vtheofylaktos/Astraeus-VTOL-UAV/Full-scale Astraeus/Drone CAD/render fulldrone.PNG

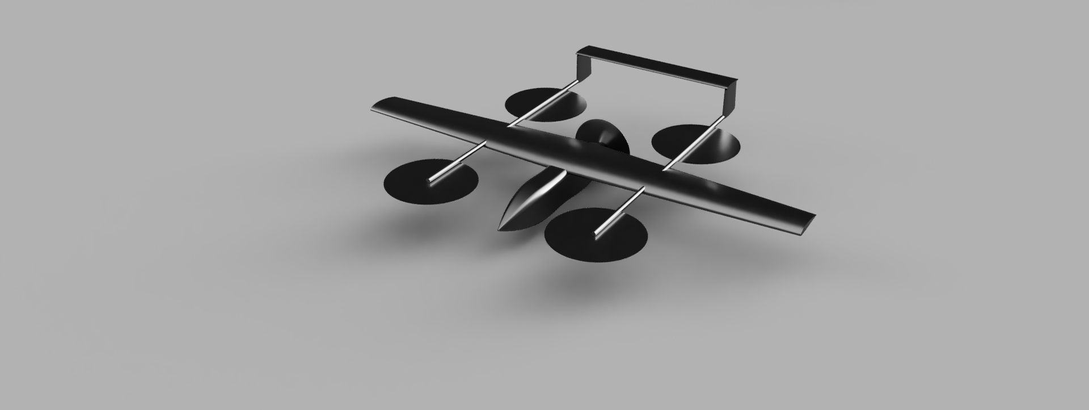
Full-scale Astraeus/Drone CAD/render fulldrone.PNG
