vtheofylaktos/Astraeus-VTOL-UAV/Full-scale Astraeus/Electrical simulations/propcalc/propCalc1/firstss.png

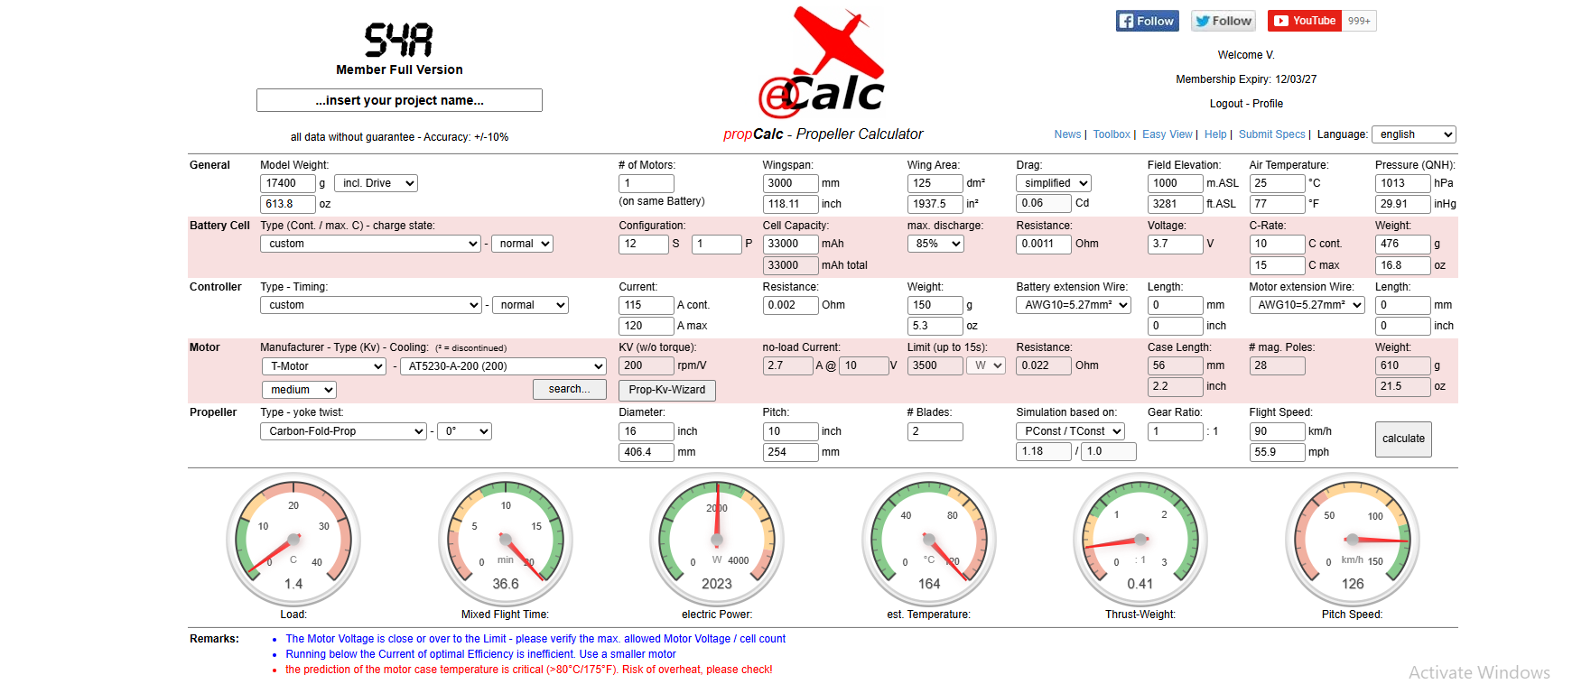
Full-scale Astraeus/Electrical simulations/propcalc/propCalc1/firstss.png
