vtheofylaktos/Astraeus-VTOL-UAV/Full-scale Astraeus/Electrical simulations/propcalc/propCalc1/fourth.png

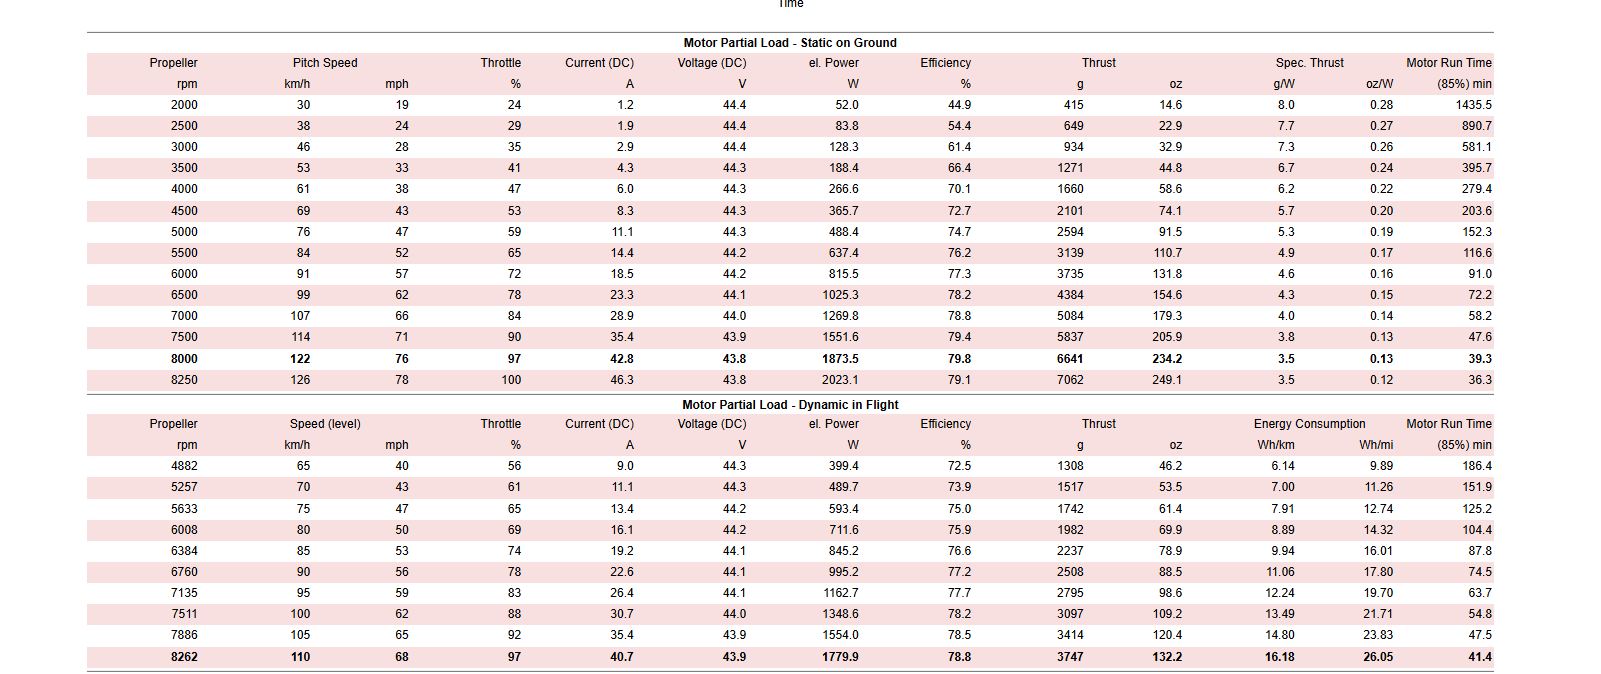
Full-scale Astraeus/Electrical simulations/propcalc/propCalc1/fourth.png
