vtheofylaktos/Astraeus-VTOL-UAV/Full-scale Astraeus/Electrical simulations/propcalc/propCalc1/second.png

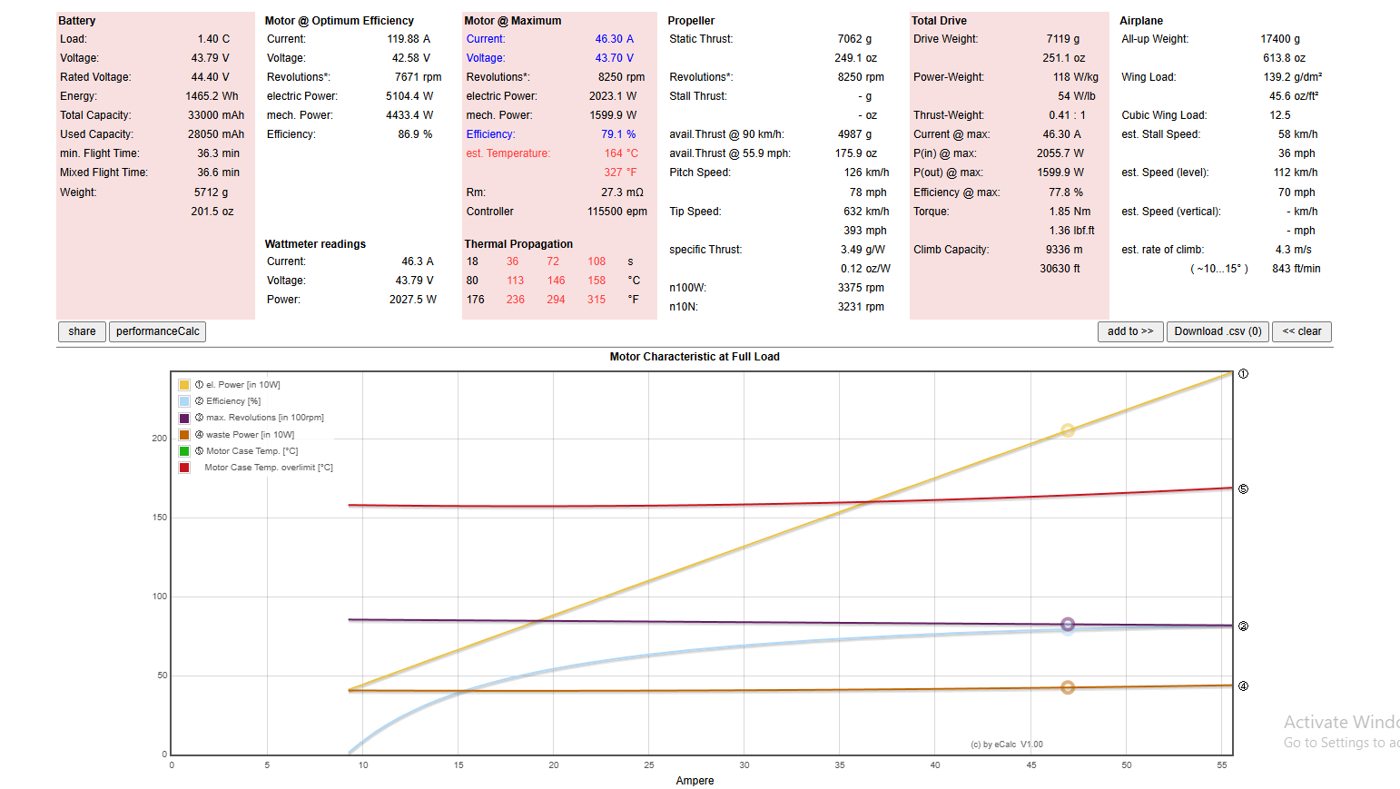
Full-scale Astraeus/Electrical simulations/propcalc/propCalc1/second.png
