vtheofylaktos/Astraeus-VTOL-UAV/Full-scale Astraeus/Electrical simulations/propcalc/propCalc1/third.png

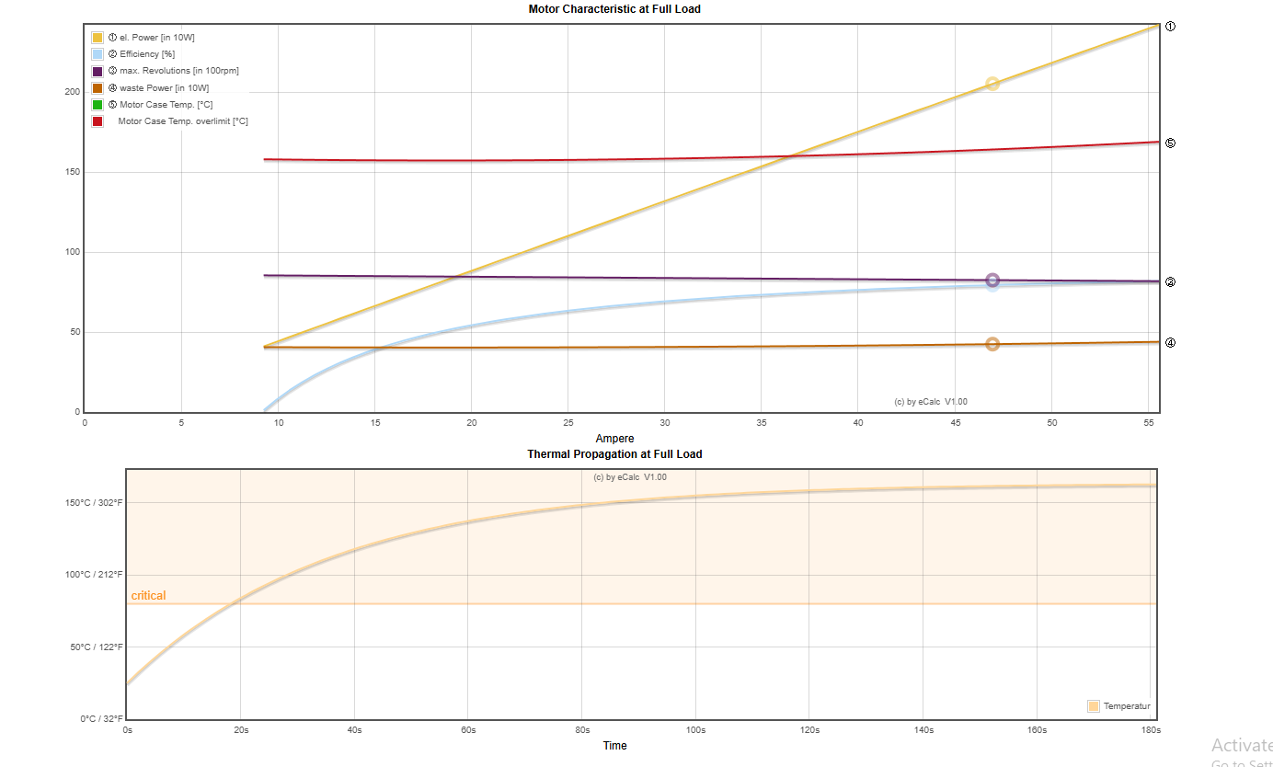
Full-scale Astraeus/Electrical simulations/propcalc/propCalc1/third.png
