vtheofylaktos/Astraeus-VTOL-UAV/Full-scale Astraeus/Electrical simulations/propcalc/propCalc2/propCalcSimulation.PNG

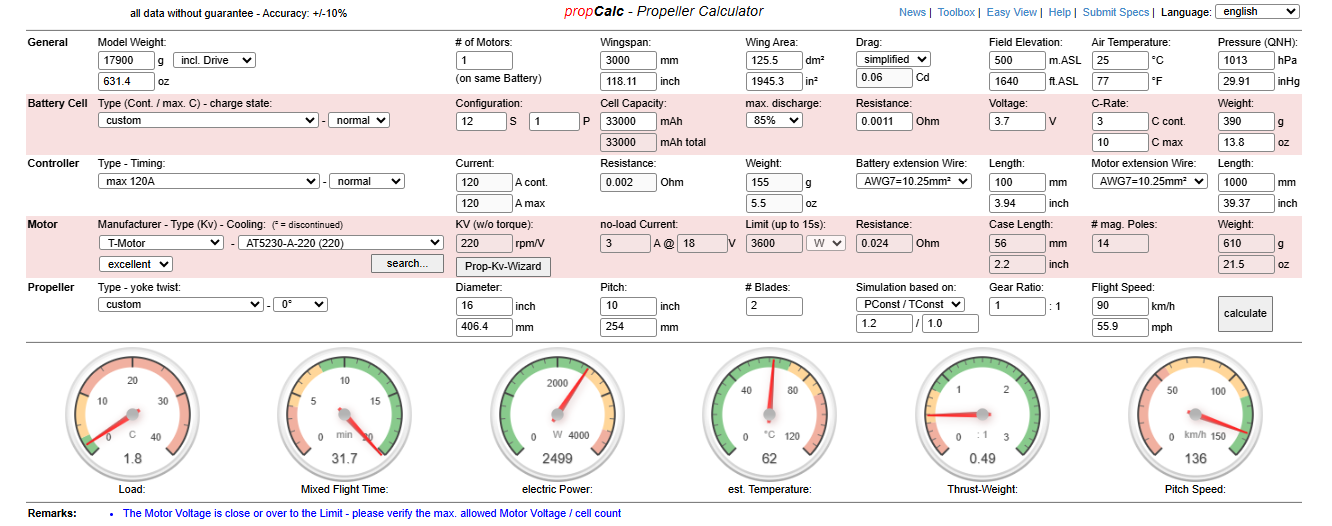
Full-scale Astraeus/Electrical simulations/propcalc/propCalc2/propCalcSimulation.PNG
