vtheofylaktos/Astraeus-VTOL-UAV/Full-scale Astraeus/Electrical simulations/xcopter/xcopter1/Screenshot 2026-03-13 004834.png

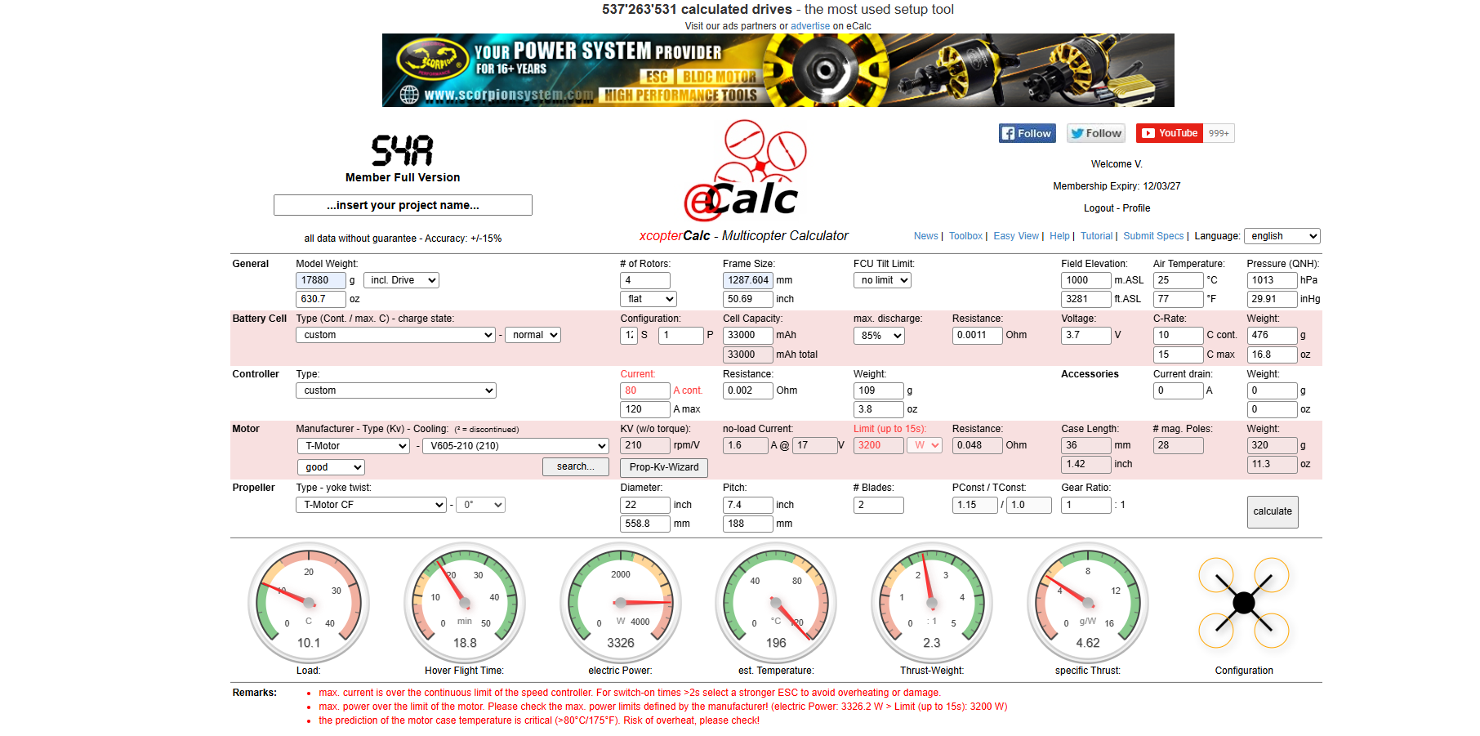
Full-scale Astraeus/Electrical simulations/xcopter/xcopter1/Screenshot 2026-03-13 004834.png
