vtheofylaktos/Astraeus-VTOL-UAV/Full-scale Astraeus/Electrical simulations/xcopter/xcopter1/Screenshot 2026-03-13 004920.png

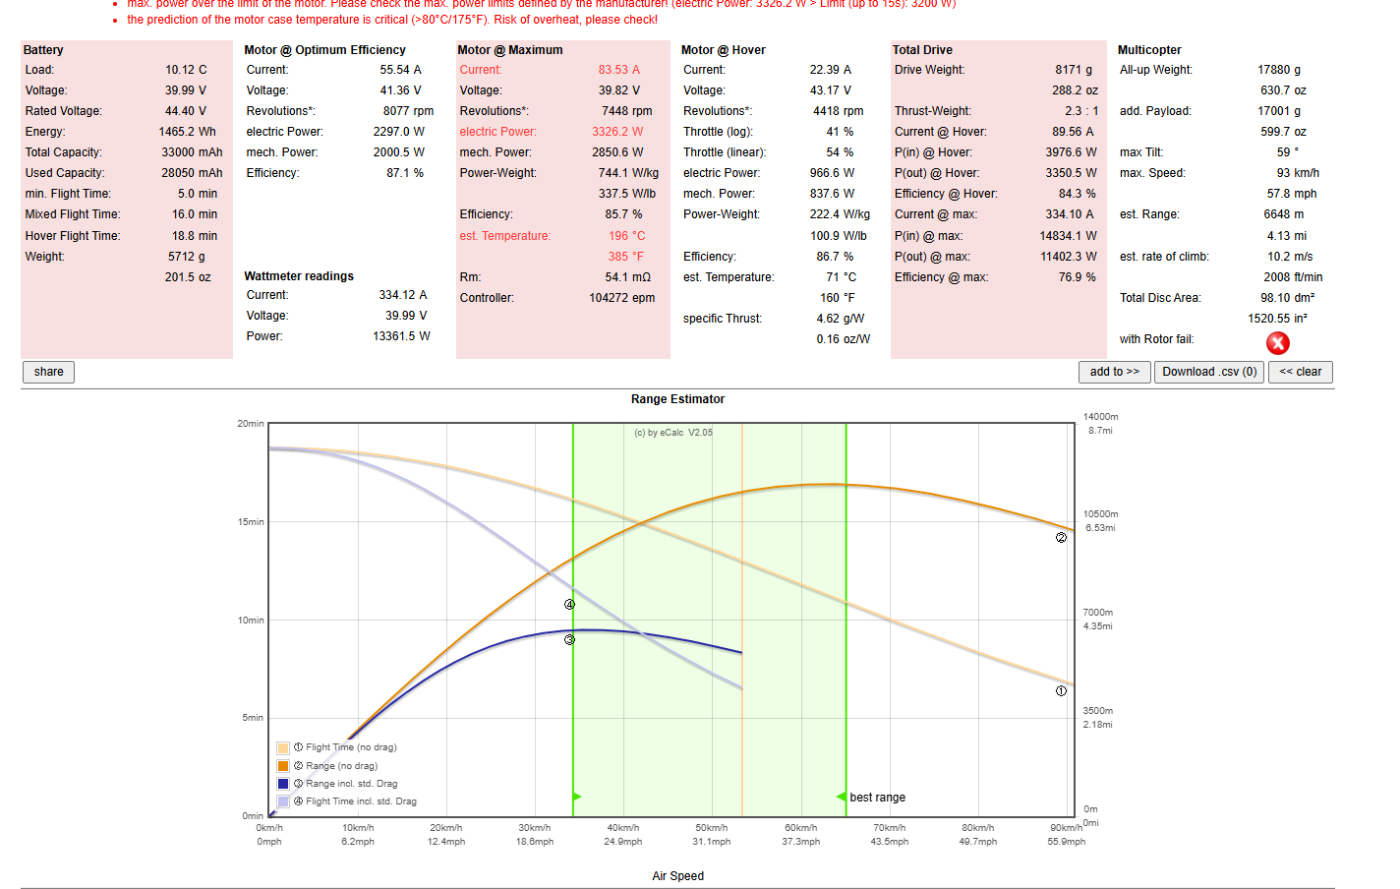
Full-scale Astraeus/Electrical simulations/xcopter/xcopter1/Screenshot 2026-03-13 004920.png
