vtheofylaktos/Astraeus-VTOL-UAV/Full-scale Astraeus/Electrical simulations/xcopter/xcopter2/NewSimulation2.PNG

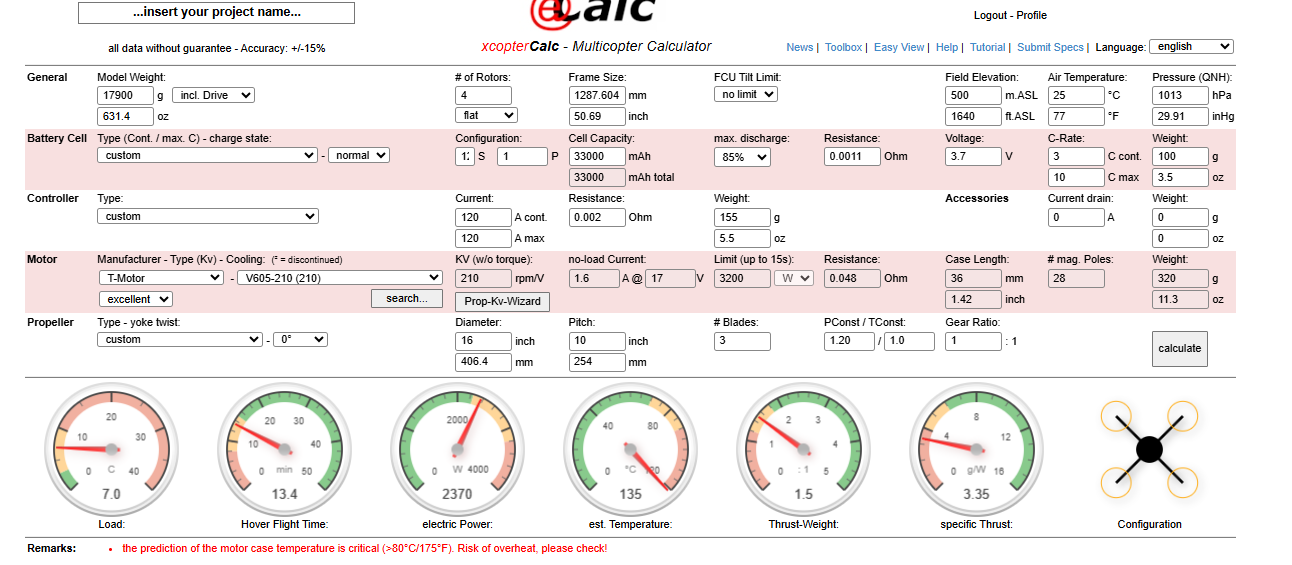
Full-scale Astraeus/Electrical simulations/xcopter/xcopter2/NewSimulation2.PNG
