vtheofylaktos/Astraeus-VTOL-UAV/Full-scale Astraeus/Electrical simulations/xcopter/xcopter2/NewSimulation3.PNG

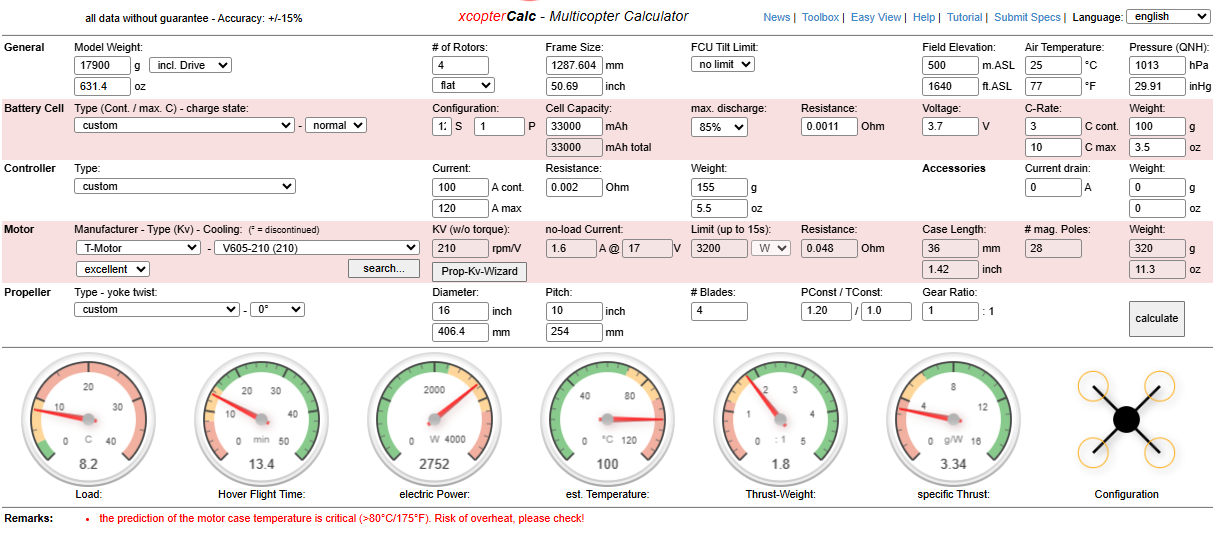
Full-scale Astraeus/Electrical simulations/xcopter/xcopter2/NewSimulation3.PNG
