vtheofylaktos/Astraeus-VTOL-UAV/Proof of concept Astraeus/Drone_Equipment.csv

Electrical-Electronics of ProjectGAIA_poc
Component | Description | Amount | Cost per Unit | Total Cost
Pixhawk 6C(aluminum case) &PM07 Power module | FC&Cables&PDB | 1 | 217.76 € | 217.76 €
Tattu 7000mAh 6S 22.2V 25C Lipo Battery pack with XT90 | Battery | 1 | 145.87 € | 145.87 €
Matek Airspeed sensor AS-DLVR-I2C | Airspeed sensor | 1 | 90.99 € | 90.99 €
Holybro M10 GPS | GPS | 1 | 39.95 € | 39.95 €
Lidar Holybro ST VL53L1X | Lidar | 1 | 18.10 € | 18.10 €
iSDT Q6 Nano 200W | Battery Charger | 1 | 40.50 € | 40.50 €
Pololu 5V, 5A Step-Down Voltage Regulator | DC-DC converter to 5V | 1 | 37.99 € | 37.99 €
Holybro Pixhawk 6C Cable Set | Cables for the sensors | 1 | 32.70 € | 32.70 €
SiK Telemetry Radio V3 - 100mW 433MHz | telemetry module | 1 | 70.20 € | 70.20 €
6-Pin JST GH Cable – 5 cm & 20 cm for GPS, UART | Connector for the telem_mo | 1 | 5.56 € | 5.56 €
Tarot 4114 320kv Brushless Multicopter Motor 6S 148g TL100B08-01 | VTOL MOTORS | 4 | 62.90 € | 251.60 €
T-Motor AT3520 550kv Brushless Motor 4S-6S 218g | Cruise MOTOR | 1 | 79.90 € | 79.90 € | Overpower
ESC Hobbywing SKYWALKER 50A-6S-V2 | Cruise ESC | 1 | 21.10 € | 21.10 €
ESC Hobbywing Xrotor 40A 2-6S No BEC | VTOL ESC | 4 | 16.70 € | 66.80 €
JX Servo PDI-1109MG | Servo Motor | 4 | 10.9 | 43.6 | https://www.rotorama.com/product/jx-pdi-1109mg-9g-servo
Mechanical of ProjectGAIA_poc
Solid carbon rod | Carbon rad 1m | 1 | 5 | 5
3k carbon fiber tube | carbon fiber tube 1m | 5 | 23.5 | 117.5
PLA+ | PLA+ 3kg | 1 | 50 | 50
PETG | 1kg PETG | 1 | 20 | 20
 |  |  |  | 1,119.02 €
