vtheofylaktos/Astraeus-VTOL-UAV/(list of files, cad)

Other CAD files:
Full-scale Astraeus/Drone CAD/Whole Drone simple.f3d
Full-scale Astraeus/Drone CAD/Whole Drone with components.f3d
